jonnylin22/CubeSat-Communications-Board-Fall-2025-V2/README.md

# UCI CubeSat Communications Board Version 2 #

Features pinout connector to external MCU  
RX and TX status LEDs  
Organized BOM
