jonnylin22/CubeSat-Communications-Board-Fall-2025-V2/3D-models/passives/PESD5V5C1BL-QYL.stp

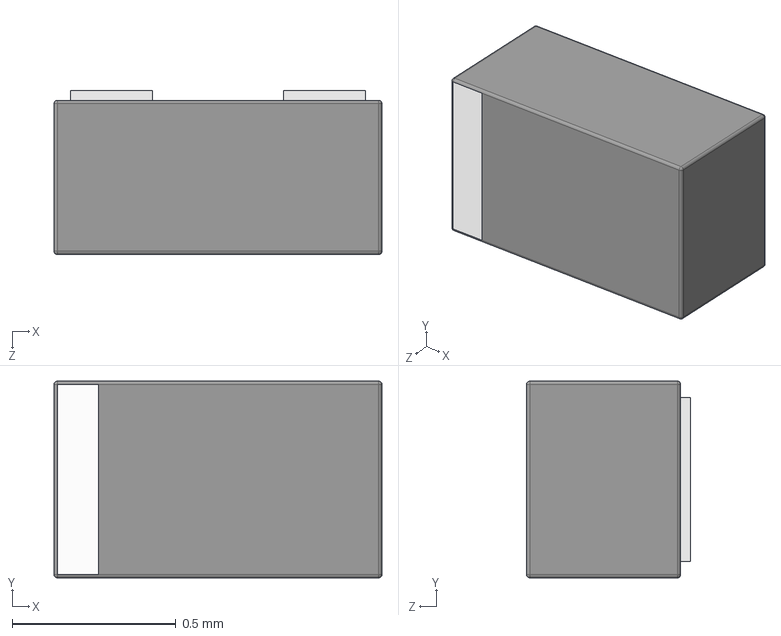
[picture p1: CAD file, 2025-12-03]
3D-models/passives/PESD5V5C1BL-QYL.stp
1.00 x 0.6 x 0.5 mm
