jonnylin22/CubeSat-Communications-Board-Fall-2025-V2/3D-models/RC0805FR-0756KL.step

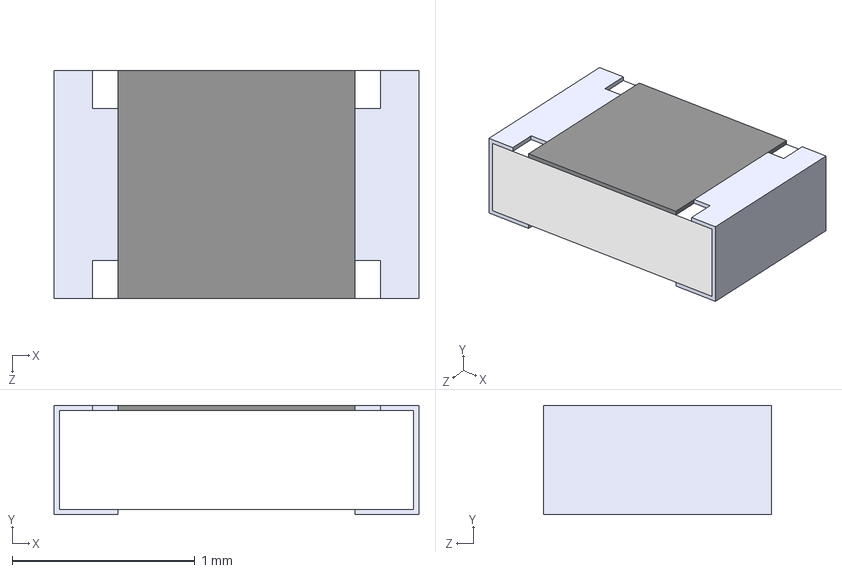
[picture p2: CAD file, 2025-11-20]
3D-models/RC0805FR-0756KL.step
2.00 x 0.6 x 1.25 mm
