jonnylin22/CubeSat-Communications-Board-Fall-2025-V2/3D-models/passives/PESD4V0X2UMZ-3D.step

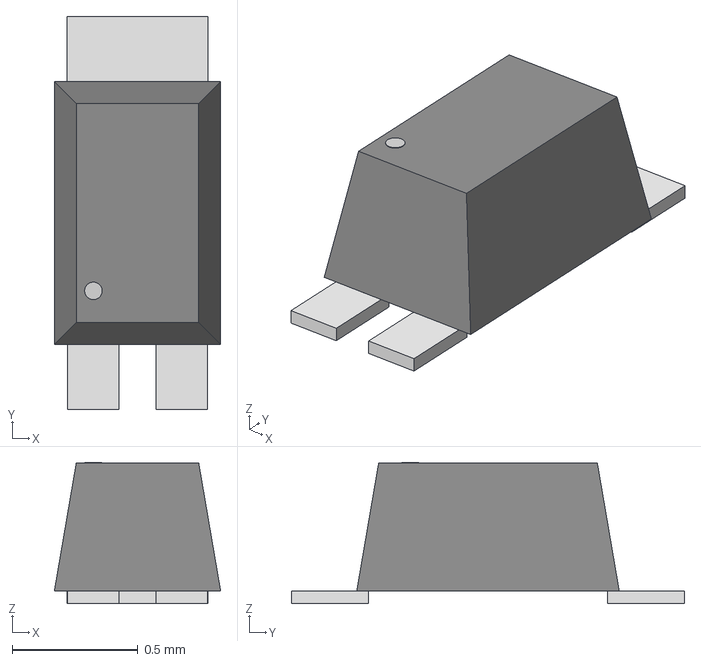
[picture p3: CAD file, 2025-12-03]
3D-models/passives/PESD4V0X2UMZ-3D.step
0.66 x 1.56 x 0.561 mm
