jonnylin22/CubeSat-Communications-Board-Fall-2025-V2/3D-models/NX3225GA-26MHZ-TI.stp

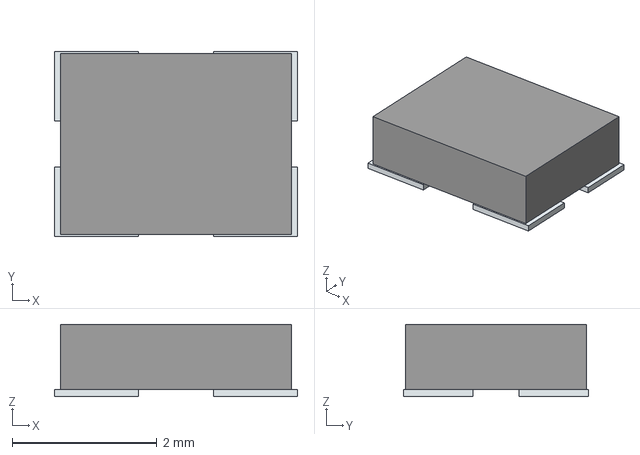
[picture p4: CAD file, 2025-11-20]
3D-models/NX3225GA-26MHZ-TI.stp
3.36 x 2.56 x 1.00 mm
Pins
