jonnylin22/CubeSat-Communications-Board-Fall-2025-V2/3D-models/passives/G-188_MUR.step

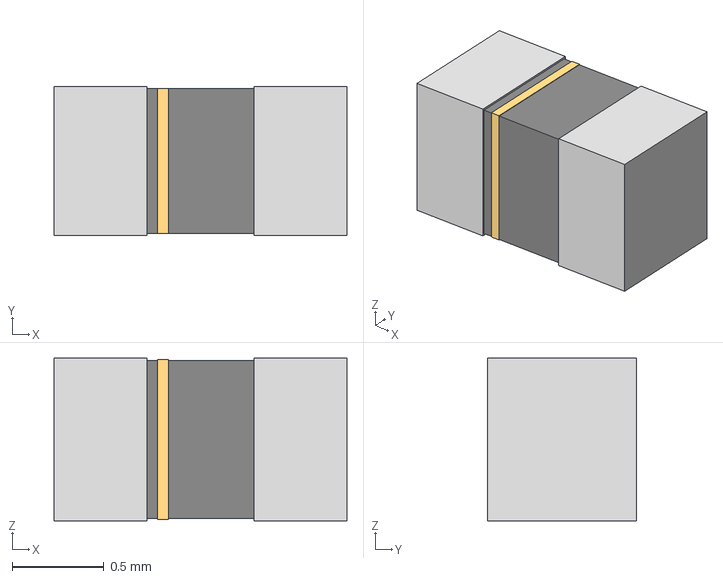
[picture p5: CAD file, 2025-11-20]
3D-models/passives/G-188_MUR.step
1.60 x 0.812 x 0.889 mm
