jonnylin22/CubeSat-Communications-Board-Fall-2025-V2/3D-models/passives/LQG15HS4N7S02D.step

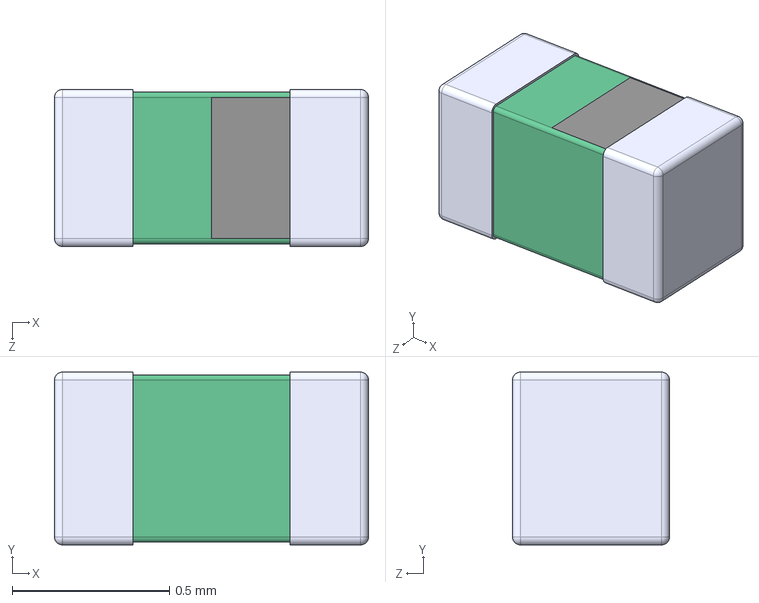
[picture p6: CAD file, 2025-11-20]
3D-models/passives/LQG15HS4N7S02D.step
1.00 x 0.55 x 0.5 mm
