jonnylin22/CubeSat-Communications-Board-Fall-2025-V2/3D-models/CAP_600S0R1AT250XT_ATC.step

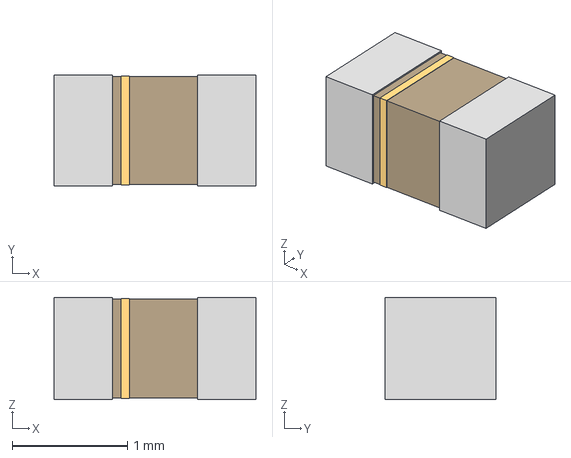
[picture p7: CAD file, 2025-11-20]
3D-models/CAP_600S0R1AT250XT_ATC.step
1.75 x 0.966 x 0.889 mm
