jonnylin22/CubeSat-Communications-Board-Fall-2025-V2/3D-models/RGP0020H.stp

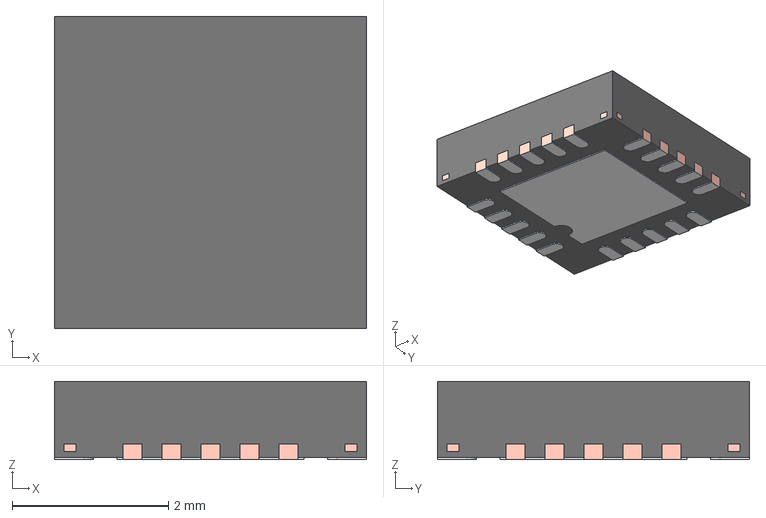
[picture p8: CAD file, 2025-11-20]
3D-models/RGP0020H.stp
4.00 x 4.00 x 1.00 mm
FRAME
