jonnylin22/CubeSat-Communications-Board-Fall-2025-V2/3D-models/XDFN8_1P7X1P3_ONS.step

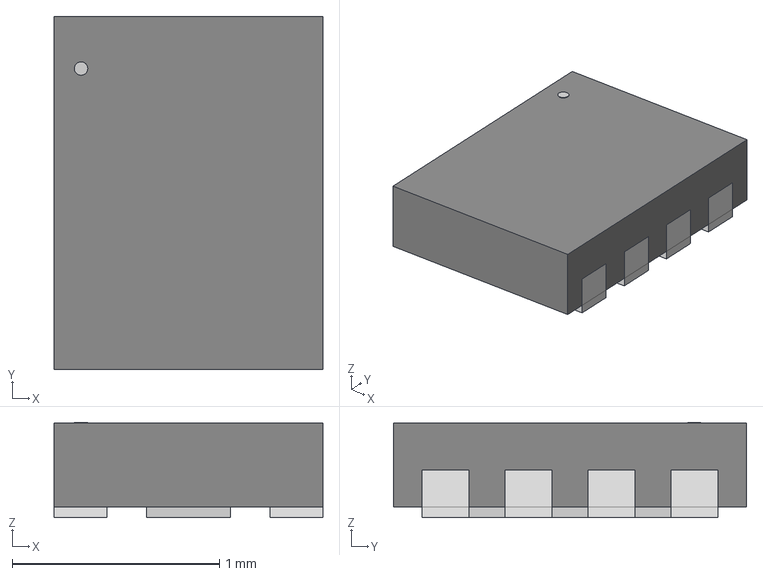
[picture p9: CAD file, 2025-11-20]
3D-models/XDFN8_1P7X1P3_ONS.step
1.30 x 1.70 x 0.46 mm
