jonnylin22/CubeSat-Communications-Board-Fall-2025-V2/3D-models/B39431R0900U410_QUA.step

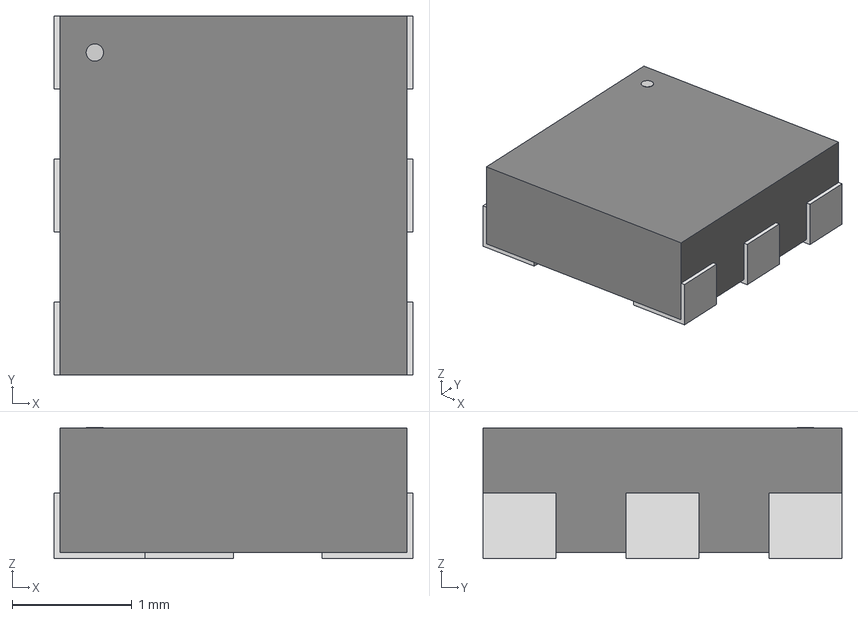
[picture p10: CAD file, 2025-11-20]
3D-models/B39431R0900U410_QUA.step
3.00 x 3.00 x 1.09 mm
