jonnylin22/CubeSat-Communications-Board-Fall-2025-V2/CubeSat-Comms-XCVR-PCB-Fall2025-Version.kicad_pcb

## KiCad design CubeSat-Comms-XCVR-PCB-Fall2025-Version.kicad_pcb (2025-12-15)

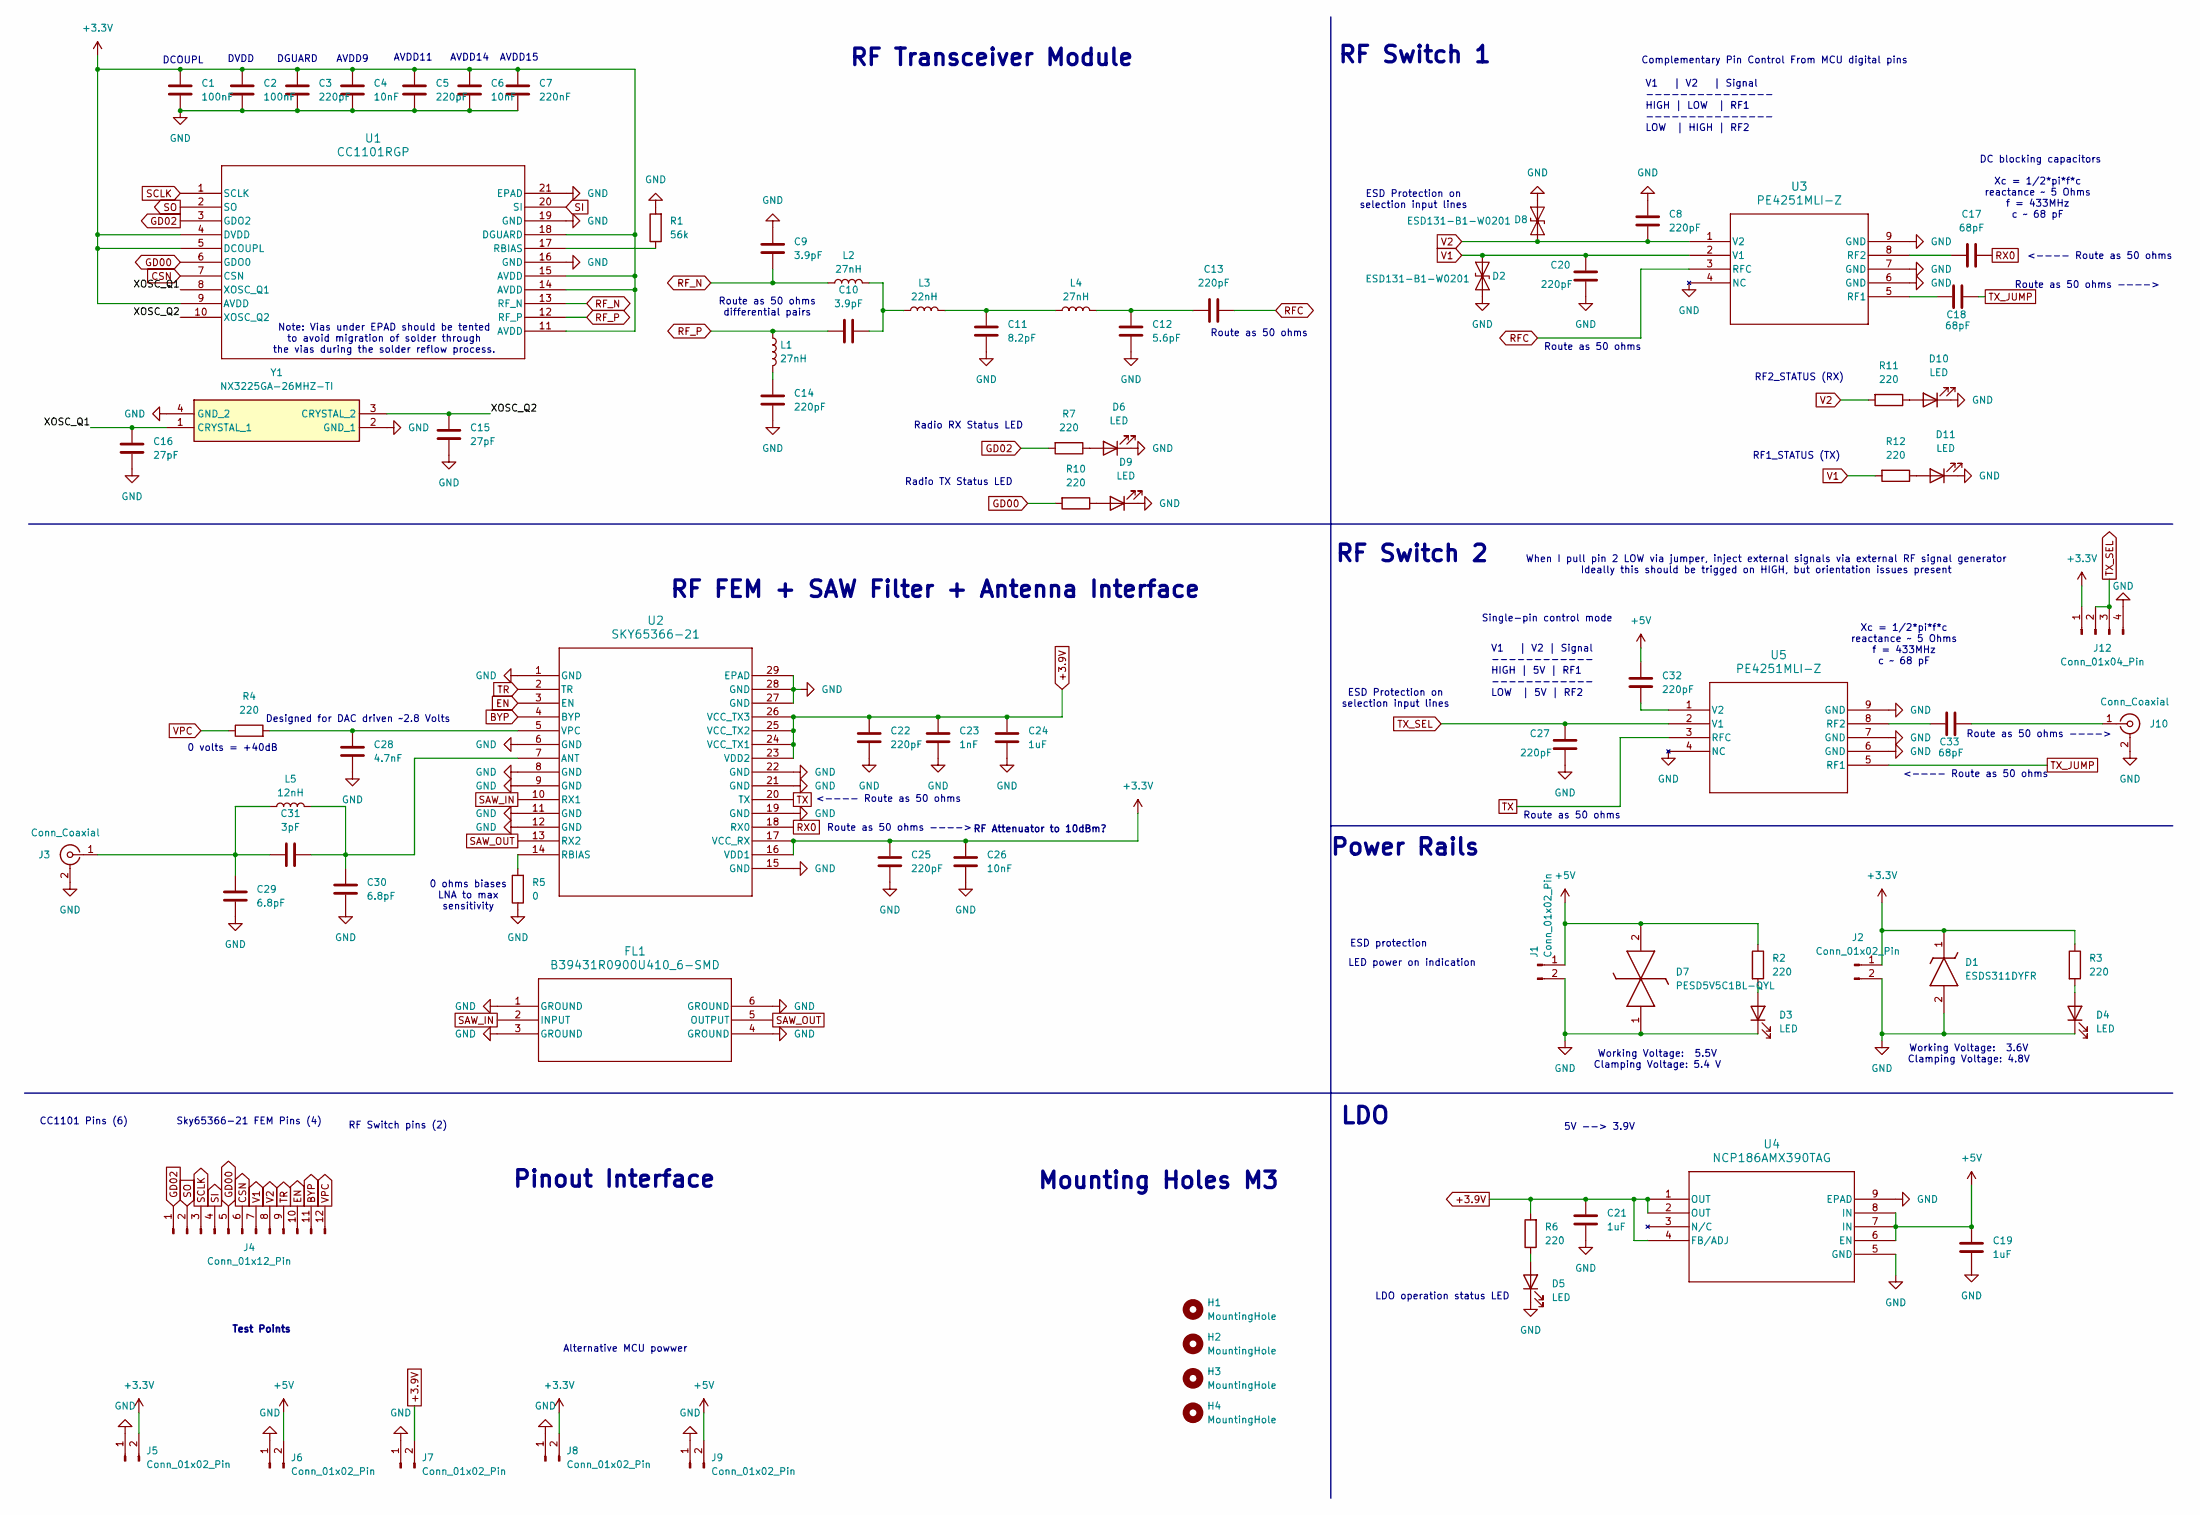
[picture p11: schematic CubeSat-Comms-XCVR-PCB-Fall2025-Version.kicad_sch]

Parts:
C1, C2: 100nF; G-188_MUR-L-100nF-GRM188; Manufacturer_Part_Number GRM188R72A104KA35D; LCSC Part # C77058
C3, C5, C8, C13, C14, C20, C22, C25, C27, C32: 220pF; G-188_MUR-L-100nF-GRM188; Manufacturer_Part_Number GCM1885C1H221JA16D; LCSC Part # C126556
C4, C6, C26: 10nF; G-188_MUR-L-100nF-GRM188; Manufacturer_Part_Number GRM188R72A103KA01D; LCSC Part # C162275
C7: 220nF; G-188_MUR-L-100nF-GRM188; Manufacturer_Part_Number GRM188R71E224KA88D; LCSC Part # C77051
C9, C10: 3.9pF; CAP_600S0R1AT250XT_ATC; Manufacturer_Part_Number Kyocera AVX 600S3R9BT250XT; LCSC Part # C3849659
C11: 8.2pF; G-188_MUR-L-100nF-GRM188; Manufacturer_Part_Number GQM1875C2E8R2CB12D; LCSC Part # C3874850
C12: 5.6pF; G-188_MUR-L-100nF-GRM188; Manufacturer_Part_Number GQM1875C2E5R6BB12D; LCSC Part # C2297617
C15, C16: 27pF; G-188_MUR-L-100nF-GRM188; Manufacturer_Part_Number GCM1885C2A270JA16D; LCSC Part # C909846
C17, C18, C33: 68pF; G-188_MUR-L-100nF-GRM188; Manufacturer_Part_Number GCM1885C2A680JA16D; LCSC Part # C701299
C19, C21, C24: 1uF; G-188_MUR-L-100nF-GRM188; Manufacturer_Part_Number GRT188R61H105KE13D; LCSC Part # C126631
C23: 1nF; G-188_MUR-L-100nF-GRM188; Manufacturer_Part_Number GRM1885C1H102JA01D; LCSC Part # C77026
C28: 4.7nF; G-188_MUR-L-100nF-GRM188; Manufacturer_Part_Number GCM188R72A472KA37D; LCSC Part # C426631
C29, C30: 6.8pF; G-188_MUR-L-100nF-GRM188; Manufacturer_Part_Number GCM1885C2A6R8DA16D; LCSC Part # C2212439
C31: 3pF; G-188_MUR-L-100nF-GRM188; Manufacturer_Part_Number GQM1875C2E3R0BB12D; LCSC Part # C2178931
D1: ESDS311DYFR; Manufacturer_Part_Number ESDS311DYFR; Mouser Part Number 595-ESDS311DYFR
D2, D8: ESD131-B1-W0201; Infineon_SG-WLL-2-3_0.58x0.28_P0.36mm
D3, D4, D5, D6, D9, D10, D11: LED; LED_0805_2012Metric_Pad1.15x1.40mm_HandSolder
D7: PESD5V5C1BL-QYL; PESD5V5C1BLQYL; Manufacturer_Part_Number PESD5V5C1BL-QYL; Mouser Part Number 771-PESD5V5C1BL-QYL
FL1: B39431R0900U410_6-SMD; B39431R0900U410_QUA; Manufacturer_Part_Number B39431B3710U410; LCSC Part # C2649317
H1, H2, H3, H4: MountingHole; MountingHole_3.2mm_M3_DIN965_Pad_TopBottom
J1, J2: Conn_01x02_Pin; JST_XH_B2B-XH-A_1x02_P2.50mm_Vertical
J3, J10: Conn_Coaxial; SMA_Amphenol_132134-11_Vertical; Manufacturer_Part_Number 132134; LCSC Part # C3174425
J4: Conn_01x12_Pin; PinSocket_1x12_P2.54mm_Vertical
J5, J6, J7: Conn_01x02_Pin; PinHeader_1x02_P2.54mm_Vertical
J8, J9: Conn_01x02_Pin; PinSocket_1x02_P2.54mm_Vertical
J12: Conn_01x04_Pin; PinHeader_1x04_P2.54mm_Vertical
L1, L2, L4: 27nH; INDC1005X55N; Manufacturer_Part_Number LQG15HS4N7S02D; LCSC Part # C86065
L3: 22nH; INDC1005X55N; Manufacturer_Part_Number LQG15HS22NJ02D; LCSC Part # C12670
L5: 12nH; INDC1005X55N; Manufacturer_Part_Number LQG15HS12NJ02D; LCSC Part # C77104
R1: 56k; RESC2012X60N; Manufacturer_Part_Number YAGEO RC0805FR-0756KL; LCSC Part # C137509
R2, R3, R4, R6, R7, R10, R11, R12: 220; RESC2012X60N; Manufacturer_Part_Number AC0805FR-07220RL; LCSC Part # C138270
R5: 0; CAPC1005X60
U1: CC1101RGP; RGP20_2P4X2P4
U2: SKY65366-21; SKY65366-21_SKY
U3, U5: PE4251MLI-Z; 8-MSOP_PE4251_PSM
U4: NCP186AMX390TAG; XDFN8_1P7X1P3_ONS
Y1: NX3225GA-26MHZ-TI; NX3225GA26MHZTI; Mouser Part Number 344-NX3225GA26MHZTI

Connections:
+3.3V: C1.1, C2.1, C3.1, C4.1, C5.1, C6.1, C7.1, C25.1, C26.1, D1.1 (K), J2.1, J5.2, J8.2, J12.1, R3.1, U1.4 (DVDD), U1.5 (DCOUPL), U1.9 (AVDD), U1.11 (AVDD), U1.14 (AVDD), U1.15 (AVDD), U1.18 (DGUARD), U2.16 (VDD1), U2.17 (VCC_RX)
+3.9V: C21.1, C22.1, C23.1, C24.1, J7.2, R6.2, U2.23 (VDD2), U2.24 (VCC_TX1), U2.25 (VCC_TX2), U2.26 (VCC_TX3), U4.1 (OUT), U4.2 (OUT), U4.4 (FB/ADJ)
+5V: C19.1, C32.2, D7.2 (K2), J1.1, J6.2, J9.2, R2.1, U4.6 (EN), U4.7 (IN), U4.8 (IN)
/XOSC_Q1: C16.2, U1.8 (XOSC_Q1), Y1.1 (CRYSTAL_1)
/XOSC_Q2: C15.2, U1.10 (XOSC_Q2), Y1.3 (CRYSTAL_2)
BYP: J4.11, U2.4 (BYP)
CSN: J4.6, U1.7 (CSN)
EN: J4.10, U2.3 (EN)
GD00: J4.5, R10.2, U1.6 (GDO0)
GD02: J4.1, R7.2, U1.3 (GDO2)
GND: C1.2, C2.2, C3.2, C4.2, C5.2, C6.2, C7.2, C8.2, C9.1, C11.1, C12.1, C14.1, C15.1, C16.1, C19.2, C20.1, C21.2, C22.2, C23.2, C24.2, C25.2, C26.2, C27.1, C28.2, C29.2, C30.2, D1.2 (A), D2.1 (A1), D3.1 (K), D4.1 (K), D5.1 (K), D6.1 (K), D7.1 (K1), D8.1 (A1), D9.1 (K), D10.1 (K), D11.1 (K), FL1.1 (GROUND), FL1.3 (GROUND), FL1.4 (GROUND), FL1.6 (GROUND), J1.2, J2.2, J3.2 (Ext), J5.1, J6.1, J7.1, J8.1, J9.1, J10.2 (Ext), J12.4, R1.2, R5.1, U1.16 (GND), U1.19 (GND), U1.21 (EPAD), U1.V, U2.1 (GND), U2.6 (GND), U2.8 (GND), U2.9 (GND), U2.11 (GND), U2.12 (GND), U2.15 (GND), U2.19 (GND), U2.21 (GND), U2.22 (GND), U2.27 (GND), U2.28 (GND), U2.29 (EPAD), U3.4 (NC), U3.6 (GND), U3.7 (GND), U3.9 (GND), U4.5 (GND), U4.9 (EPAD), U5.4 (NC), U5.6 (GND), U5.7 (GND), U5.9 (GND), Y1.2 (GND_1), Y1.4 (GND_2)
unnamed: C10.2, L2.2, L3.1
unnamed: C11.2, L3.2, L4.1
unnamed: C12.2, C13.2, L4.2
unnamed: C14.2, L1.2
unnamed: D3.2 (A), R2.2
unnamed: D4.2 (A), R3.2
unnamed: D5.2 (A), R6.1
unnamed: D6.2 (A), R7.1
unnamed: D9.2 (A), R10.1
unnamed: D10.2 (A), R11.1
unnamed: D11.2 (A), R12.1
unnamed: C29.1, C31.1, J3.1 (In), L5.1
unnamed: C33.1, J10.1 (In)
unnamed: R1.1, U1.17 (RBIAS)
unnamed: C30.1, C31.2, L5.2, U2.7 (ANT)
unnamed: R5.2, U2.14 (RBIAS)
unnamed: C28.1, R4.2, U2.5 (VPC)
unnamed: C18.2, U3.5 (RF1)
unnamed: C17.2, U3.8 (RF2)
unnamed: C33.2, U5.8 (RF2)
unnamed: C32.1, U5.1 (V2)
RFC: C13.1, U3.3 (RFC)
RF_N: C9.2, L2.1, U1.13 (RF_N)
RF_P: C10.1, L1.1, U1.12 (RF_P)
RX0: C17.1, U2.18 (RX0)
SAW_IN: FL1.2 (INPUT), U2.10 (RX1)
SAW_OUT: FL1.5 (OUTPUT), U2.13 (RX2)
SCLK: J4.3, U1.1 (SCLK)
SI: J4.4, U1.20 (SI)
SO: J4.2, U1.2 (SO)
TR: J4.9, U2.2 (TR)
TX: U2.20 (TX), U5.3 (RFC)
TX_JUMP: C18.1, U5.5 (RF1)
TX_SEL: C27.2, J12.2, J12.3, U5.2 (V1)
V1: C20.2, D2.2 (A2), J4.7, R12.2, U3.2 (V1)
V2: C8.1, D8.2 (A2), J4.8, R11.2, U3.1 (V2)
VPC: J4.12, R4.1

Notes on the sheet:
Single-pin control mode
RF FEM + SAW Filter + Antenna Interface
Route as 50 ohms
RF Attenuator to 10dBm?
Sky65366-21 FEM Pins (4)
When I pull pin 2 LOW via jumper, inject external signals via external RF signal generator Ideally this should be trigged on HIGH, but orientation issues present
Xc = 1/2*pi*f*c reactance ~ 5 Ohms f = 433MHz c ~ 68 pF
0 volts = +40dB
RF Switch pins (2)
ESD Protection on selection input lines
AVDD14
Test Points
Route as 50 ohms ---->
LED power on indication
Alternative MCU powwer
LDO operation status LED
DCOUPL
V1 | V2 | Signal ------------ HIGH | 5V | RF1 ------------ LOW | 5V | RF2
RF Switch 1
0 ohms biases LNA to max sensitivity
RF1_STATUS (TX)
RF Transceiver Module
Radio TX Status LED
Note: Vias under EPAD should be tented to avoid migration of solder through the vias during the solder reflow process.
Route as 50 ohms differential pairs
<---- Route as 50 ohms
Pinout Interface
DC blocking capacitors
Designed for DAC driven ~2.8 Volts
5V --> 3.9V
RF2_STATUS (RX)
DVDD
CC1101 Pins (6)
AVDD11
Working Voltage: 3.6V Clamping Voltage: 4.8V
Radio RX Status LED
Complementary Pin Control From MCU digital pins
AVDD9
RF Switch 2
AVDD15
Power Rails
V1 | V2 | Signal --------------- HIGH | LOW | RF1 --------------- LOW | HIGH | RF2
Mounting Holes M3
Working Voltage: 5.5V Clamping Voltage: 5.4 V
ESD protection
LDO
DGUARD

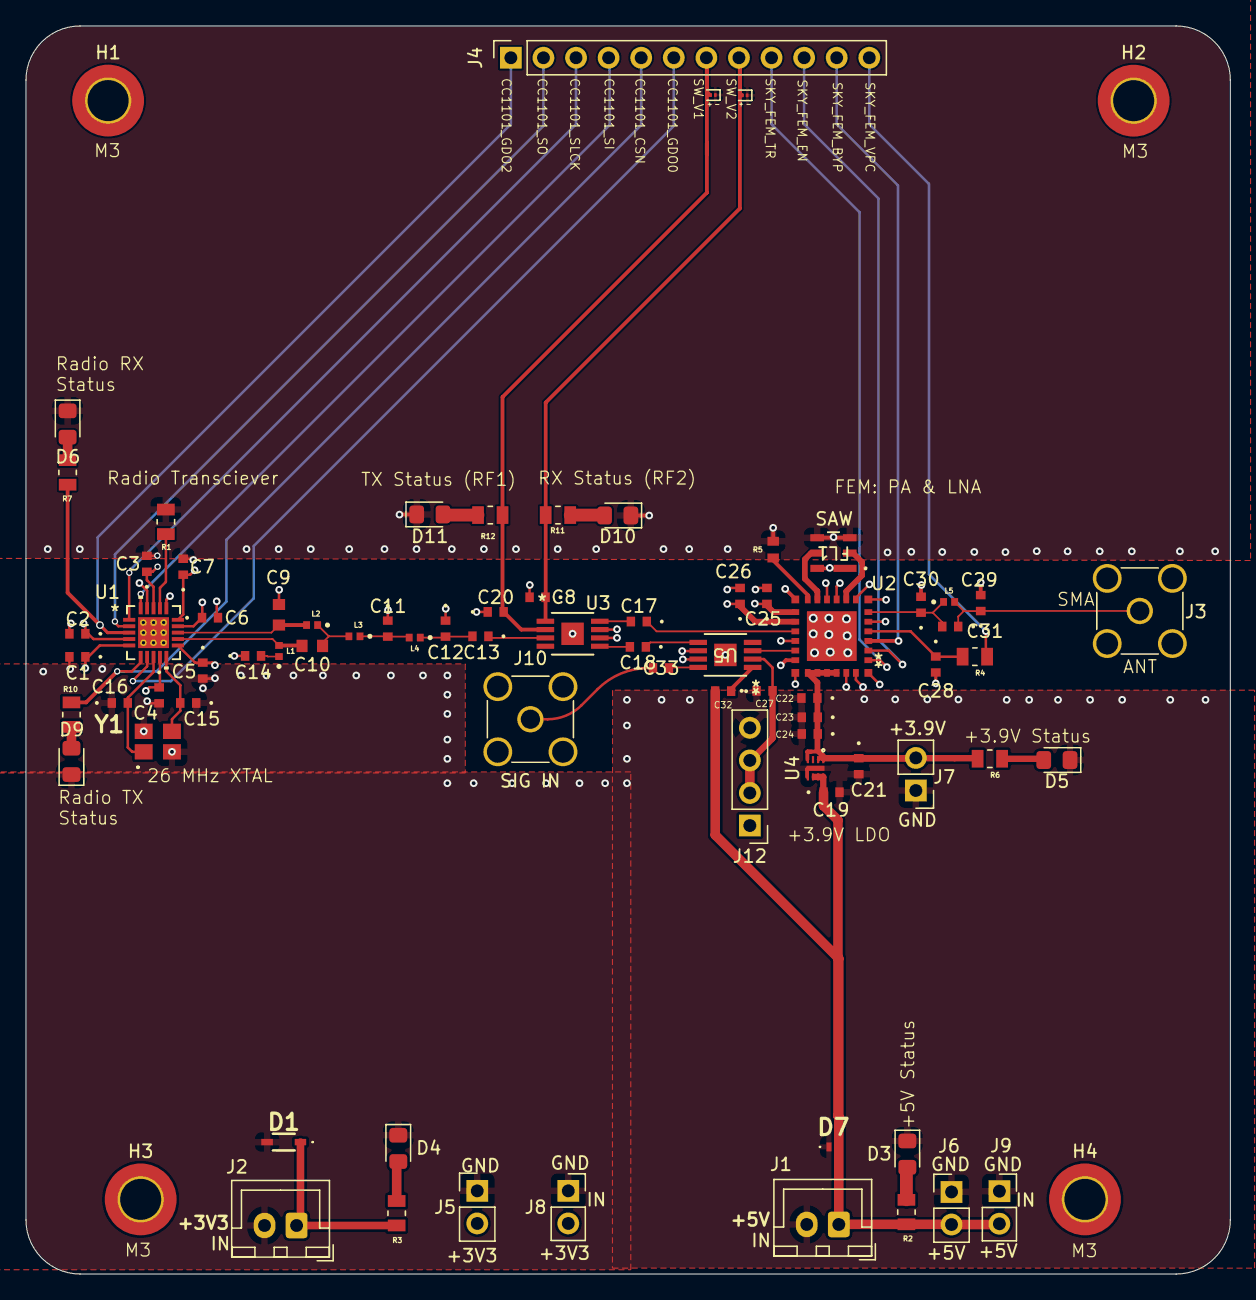
[picture p12: board CubeSat-Comms-XCVR-PCB-Fall2025-Version.kicad_pcb from above]

Board: 4 copper layers, 93.9 x 97.3 mm, 81 parts (0 on the bottom side), 48 nets.
