jonnylin22/CubeSat-Communications-Board-Fall-2025-V2/(commit log)

2025-11-20 CubeSat Comms PCB Fall 2025 Version 2
    [AC0805FR-07220RL.step, B39431R0900U410_QUA.step, CAP_600S0R1AT250XT_ATC.step, CubeSat-Comms-XCVR-PCB-Fall2025-Version.kicad_pcb, CubeSat-Comms-XCVR-PCB-Fall2025-Version.kicad_sch, G-188_MUR.step, LQG15HS4N7S02D.step, NX3225GA-26MHZ-TI.stp]
2025-11-28 updated mounting holes to have plated connections
    [CubeSat-Comms-XCVR-PCB-Fall2025-Version.kicad_sch]
2025-12-02 updated trace wiring
    [CubeSat-Comms-XCVR-PCB-Fall2025-Version.kicad_pcb, CubeSat-Comms-XCVR-PCB-Fall2025-Version.kicad_sch]
2025-12-03 revised TVS ESD protection diodes, added JST XH connectors for power
    [CubeSat-Comms-XCVR-PCB-Fall2025-Version.kicad_pcb, CubeSat-Comms-XCVR-PCB-Fall2025-Version.kicad_sch, PESD4V0X2UMZ-3D.step, PESD5V5C1BL-QYL.stp]
2025-12-03 slight edit
    [CubeSat-Comms-XCVR-PCB-Fall2025-Version.kicad_pcb]
2025-12-04 updating vivobook
    [CubeSat-Comms-XCVR-PCB-Fall2025-Version.kicad_pcb]
2025-12-04 pcb edits: sticking vias, trace routing...
    [CubeSat-Comms-XCVR-PCB-Fall2025-Version.kicad_pcb, CubeSat-Comms-XCVR-PCB-Fall2025-Version.kicad_sch]
2025-12-09 revised board clearance rules, drc, routing, placements. TODO = redundant xcvr, impedance matching
    [CubeSat-Comms-XCVR-PCB-Fall2025-Version.kicad_pcb, CubeSat-Comms-XCVR-PCB-Fall2025-Version.kicad_sch]
2025-12-09 editted silk screen and note on schematic about via tenting for CC1101 epad vias
    [CubeSat-Comms-XCVR-PCB-Fall2025-Version.kicad_pcb, CubeSat-Comms-XCVR-PCB-Fall2025-Version.kicad_sch]
2025-12-14 test points and silkscreen
    [CubeSat-Comms-XCVR-PCB-Fall2025-Version.kicad_pcb, CubeSat-Comms-XCVR-PCB-Fall2025-Version.kicad_sch]
2025-12-15 added external signal injecting capability
    [CubeSat-Comms-XCVR-PCB-Fall2025-Version.kicad_pcb, CubeSat-Comms-XCVR-PCB-Fall2025-Version.kicad_sch]
2025-12-18 empty commit
    [CubeSat-Comms-XCVR-PCB-Fall2025-Version.kicad_sch]
